mscsAhsan/smart-bin/esp32/sketch_dec25b.ino

// REDACTED COPY — Wi-Fi SSID/password and device IPs replaced with placeholders.
// Do NOT commit the original files with credentials to GitHub.
#include "esp_camera.h"
#include <WiFi.h>
#include "esp_http_server.h"

const char* ssid = "<YOUR_WIFI_SSID>";
const char* password = "<YOUR_WIFI_PASSWORD>";

#define FLASH_GPIO_NUM    4  // Flash LED Pin

// AI-Thinker Pin Definitions
#define PWDN_GPIO_NUM     32
#define RESET_GPIO_NUM    -1
#define XCLK_GPIO_NUM      0
#define SIOD_GPIO_NUM     26
#define SIOC_GPIO_NUM     27
#define Y9_GPIO_NUM       35
#define Y8_GPIO_NUM       34
#define Y7_GPIO_NUM       39
#define Y6_GPIO_NUM       36
#define Y5_GPIO_NUM       21
#define Y4_GPIO_NUM       19
#define Y3_GPIO_NUM       18
#define Y2_GPIO_NUM        5
#define VSYNC_GPIO_NUM    25
#define HREF_GPIO_NUM     23
#define PCLK_GPIO_NUM     22

esp_err_t capture_handler(httpd_req_t *req) {
    // 1. Flash ON karein
    digitalWrite(FLASH_GPIO_NUM, HIGH);
    delay(500); // Thora wait taake brightness stabilize ho jaye

    // 2. Picture capture karein
    camera_fb_t * fb = esp_camera_fb_get();
    
    // 3. Flash OFF karein
    digitalWrite(FLASH_GPIO_NUM, LOW);

    if (!fb) {
        httpd_resp_send_500(req);
        return ESP_FAIL;
    }

    httpd_resp_set_type(req, "image/jpeg");
    esp_err_t res = httpd_resp_send(req, (const char *)fb->buf, fb->len);
    
    esp_camera_fb_return(fb);
    return res;
}

void setup() {
    Serial.begin(115200);
    
    // Flash pin ko output set karein
    pinMode(FLASH_GPIO_NUM, OUTPUT);
    digitalWrite(FLASH_GPIO_NUM, LOW);

    camera_config_t config;
    config.ledc_channel = LEDC_CHANNEL_0;
    config.ledc_timer = LEDC_TIMER_0;
    config.pin_d0 = Y2_GPIO_NUM;
    config.pin_d1 = Y3_GPIO_NUM;
    config.pin_d2 = Y4_GPIO_NUM;
    config.pin_d3 = Y5_GPIO_NUM;
    config.pin_d4 = Y6_GPIO_NUM;
    config.pin_d5 = Y7_GPIO_NUM;
    config.pin_d6 = Y8_GPIO_NUM;
    config.pin_d7 = Y9_GPIO_NUM;
    config.pin_xclk = XCLK_GPIO_NUM;
    config.pin_pclk = PCLK_GPIO_NUM;
    config.pin_vsync = VSYNC_GPIO_NUM;
    config.pin_href = HREF_GPIO_NUM;
    config.pin_sscb_sda = SIOD_GPIO_NUM;
    config.pin_sscb_scl = SIOC_GPIO_NUM;
    config.pin_pwdn = PWDN_GPIO_NUM;
    config.pin_reset = RESET_GPIO_NUM;
    config.xclk_freq_hz = 20000000;
    config.pixel_format = PIXFORMAT_JPEG;

    // High Quality Settings
    config.frame_size = FRAMESIZE_XGA; 
    config.jpeg_quality = 10;
    config.fb_count = 1;

    esp_err_t err = esp_camera_init(&config);
    if (err != ESP_OK) return;

    WiFi.begin(ssid, password);
    while (WiFi.status() != WL_CONNECTED) delay(500);

    httpd_handle_t server = NULL;
    httpd_config_t server_config = HTTPD_DEFAULT_CONFIG();
    httpd_uri_t capture_uri = { .uri = "/capture", .method = HTTP_GET, .handler = capture_handler, .user_ctx = NULL };
    
    if (httpd_start(&server, &server_config) == ESP_OK) {
        httpd_register_uri_handler(server, &capture_uri);
    }
    Serial.println("\nWiFi Connected!");
    Serial.println(WiFi.localIP());
}

void loop() { delay(1); }
